sergeyyarkov/attiny2313a_thermostat/(list of files, cad)

Other CAD files:
firmware/dist/default/production/firmware.production.obj
