sergeyyarkov/attiny2313a_thermostat/(list of files, drawings)

Other design files:
proteus/thermostat.pdsprj
