sergeyyarkov/attiny2313a_thermostat/hardware/hardware/hardware.kicad_pcb

## KiCad design hardware/hardware/hardware.kicad_pcb (2023-07-24)

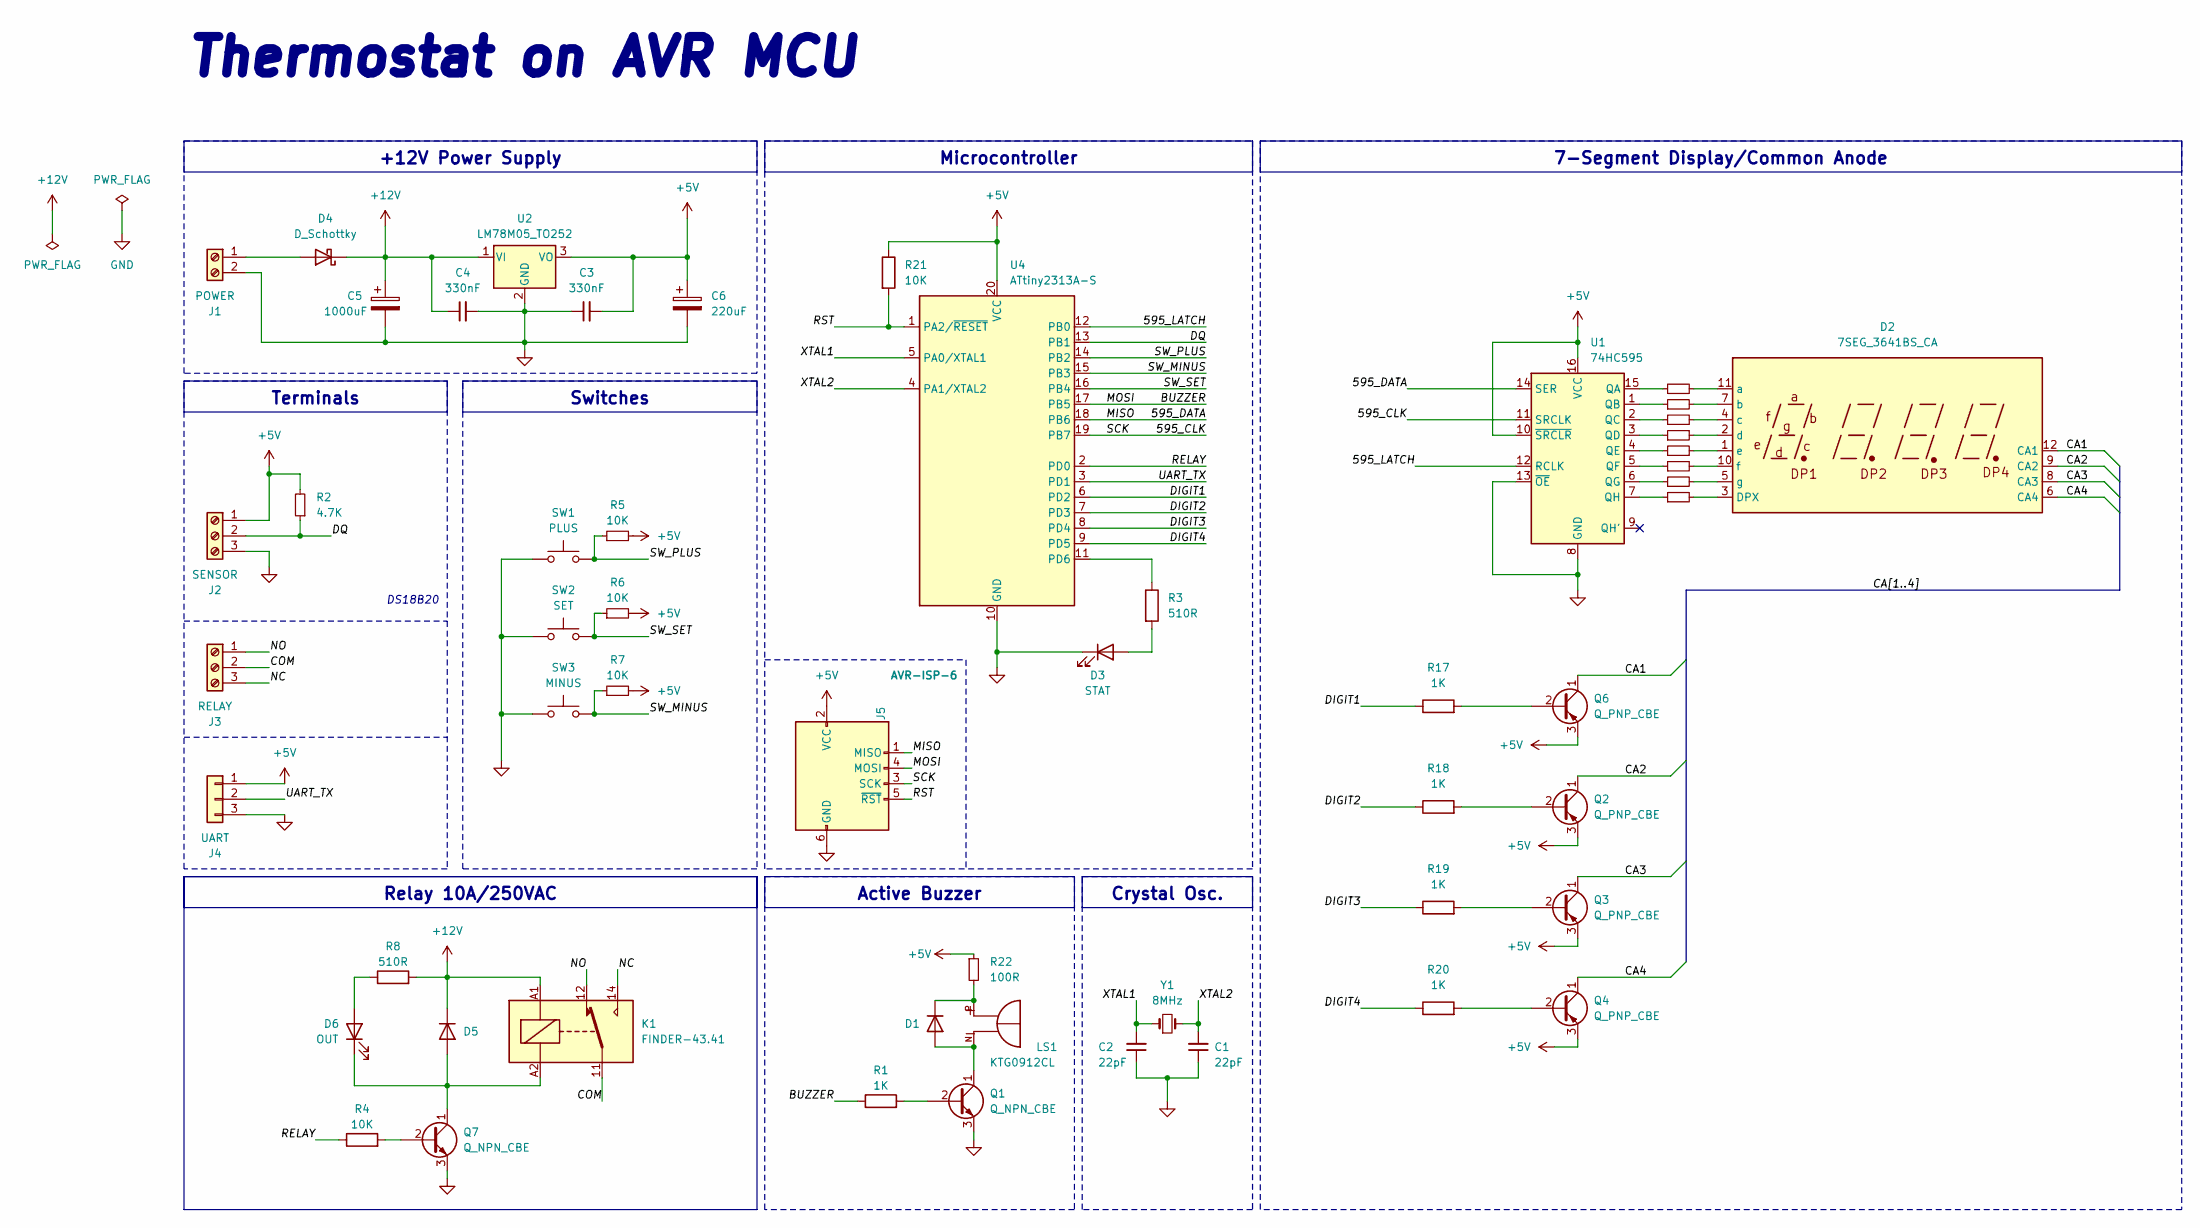
[picture p1: schematic hardware.kicad_sch, Thermostat on ATtiny2313A]

Parts:
C1, C2: 22pF; C_0805_2012Metric
C3, C4: 330nF; C_0805_2012Metric
C5: 1000uF; CP_Elec_10x10.5
C6: 220uF; CP_Elec_6.3x7.7
D1: 1N4448W; D_SOD-123
D2: 7SEG_3641BS_CA; 7SEG_3641BS
D3: STAT; LED_0805_2012Metric
D4: D_Schottky; D_SMA
D5: D; D_SMA
D6: OUT; LED_0805_2012Metric
J1: POWER; TerminalBlock_Phoenix_MPT-0,5-2-2.54_1x02_P2.54mm_Horizontal
J2: SENSOR; TerminalBlock_Phoenix_MPT-0,5-3-2.54_1x03_P2.54mm_Horizontal
J3: RELAY; TerminalBlock_Phoenix_MPT-0,5-3-2.54_1x03_P2.54mm_Horizontal
J4: UART; PinHeader_1x03_P2.54mm_Vertical
J5: AVR-ISP-6; PinHeader_2x03_P2.54mm_Vertical
K1: FINDER-43.41; RELAY_FINDER-43.41
LS1: KTG0912CL; XDCR_KTG0912CL; PARTREV 1.1
Q1, Q7: Q_NPN_CBE; SOT-23
Q2, Q3, Q4, Q6: Q_PNP_CBE; SOT-23
R1, R17, R18, R19, R20: 1K; R_0805_2012Metric
R2: 4.7K; R_0805_2012Metric
R3, R8: 510R; R_0805_2012Metric
R4, R5, R6, R7, R21: 10K; R_0805_2012Metric
R9, R10, R11, R12, R13, R14, R15, R16: 330R; R_0805_2012Metric
R22: 100R; R_0805_2012Metric
SW1: PLUS; SW_Push_1P1T_NO_6x6mm_H9.5mm
SW2: SET; SW_Push_1P1T_NO_6x6mm_H9.5mm
SW3: MINUS; SW_Push_1P1T_NO_6x6mm_H9.5mm
U1: 74HC595; SOIC-16W_5.3x10.2mm_P1.27mm
U2: LM78M05_TO252; TO-252-2
U4: ATtiny2313A-S; SOIC-20W_7.5x12.8mm_P1.27mm
Y1: 8MHz; Crystal_HC49-4H_Vertical

Connections:
+5V: C3.2, C6.1, J2.1, J4.1, J5.2 (VCC), Q2.3 (E), Q3.3 (E), Q4.3 (E), Q6.3 (E), R2.2, R5.2, R6.2, R7.2, R21.1, R22.1, U1.10 (~SRCLR), U1.16 (VCC), U2.3 (VO), U4.20 (VCC)
+12V: C4.1, C5.1, D4.1 (K), D5.1 (K), K1.A1, R8.2, U2.1 (VI)
/595_CLK: J5.3 (SCK), U1.11 (SRCLK), U4.19 (PB7)
/595_DATA: J5.1 (MISO), U1.14 (SER), U4.18 (PB6)
/595_LATCH: U1.12 (RCLK), U4.12 (PB0)
/BUZZER: J5.4 (MOSI), R1.1, U4.17 (PB5)
/CA1: D2.12 (CA1), Q6.1 (C)
/CA2: D2.9 (CA2), Q2.1 (C)
/CA3: D2.8 (CA3), Q3.1 (C)
/CA4: D2.6 (CA4), Q4.1 (C)
/COM: J3.2, K1.11
/DIGIT1: R17.1, U4.6 (PD2)
/DIGIT2: R18.1, U4.7 (PD3)
/DIGIT3: R19.1, U4.8 (PD4)
/DIGIT4: R20.1, U4.9 (PD5)
/DQ: J2.2, R2.1, U4.13 (PB1)
/NC: J3.3, K1.14
/NO: J3.1, K1.12
/RELAY: R4.1, U4.2 (PD0)
/RST: J5.5 (~RST), R21.2, U4.1 (PA2/~RESET)
/SW_MINUS: R7.1, SW3.2, U4.15 (PB3)
/SW_PLUS: R5.1, SW1.2, U4.14 (PB2)
/SW_SET: R6.1, SW2.2, U4.16 (PB4)
/UART_TX: J4.2, U4.3 (PD1)
/XTAL1: C2.2, U4.5 (PA0/XTAL1), Y1.1
/XTAL2: C1.2, U4.4 (PA1/XTAL2), Y1.2
GND: C1.1, C2.1, C3.1, C4.2, C5.2, C6.2, D3.1 (K), J1.2, J2.3, J4.3, J5.6 (GND), Q1.3 (E), Q7.3 (E), SW1.1, SW2.1, SW3.1, U1.8 (GND), U1.13 (~OE), U2.2 (GND), U4.10 (GND)
unnamed: D1.2 (A), LS1.N, Q1.1 (C)
unnamed: D1.1 (K), LS1.P, R22.2
unnamed: D2.3 (DPX), R16.2
unnamed: D2.11 (a), R9.2
unnamed: D2.7 (b), R10.2
unnamed: D2.4 (c), R11.2
unnamed: D2.2 (d), R12.2
unnamed: D2.1 (e), R13.2
unnamed: D2.10 (f), R14.2
unnamed: D2.5 (g), R15.2
unnamed: D3.2 (A), R3.2
unnamed: D4.2 (A), J1.1
unnamed: D5.2 (A), D6.1 (K), K1.A2, Q7.1 (C)
unnamed: D6.2 (A), R8.1
unnamed: Q1.2 (B), R1.2
unnamed: Q2.2 (B), R18.2
unnamed: Q3.2 (B), R19.2
unnamed: Q4.2 (B), R20.2
unnamed: Q6.2 (B), R17.2
unnamed: Q7.2 (B), R4.2
unnamed: R9.1, U1.15 (QA)
unnamed: R10.1, U1.1 (QB)
unnamed: R11.1, U1.2 (QC)
unnamed: R12.1, U1.3 (QD)
unnamed: R13.1, U1.4 (QE)
unnamed: R14.1, U1.5 (QF)
unnamed: R15.1, U1.6 (QG)
unnamed: R16.1, U1.7 (QH)
unnamed: R3.1, U4.11 (PD6)

Notes on the sheet:
Active Buzzer
Terminals
+12V Power Supply
Crystal Osc.
Relay 10A/250VAC
Switches
7-Segment Display/Common Anode
Microcontroller
Thermostat on AVR MCU
DS18B20

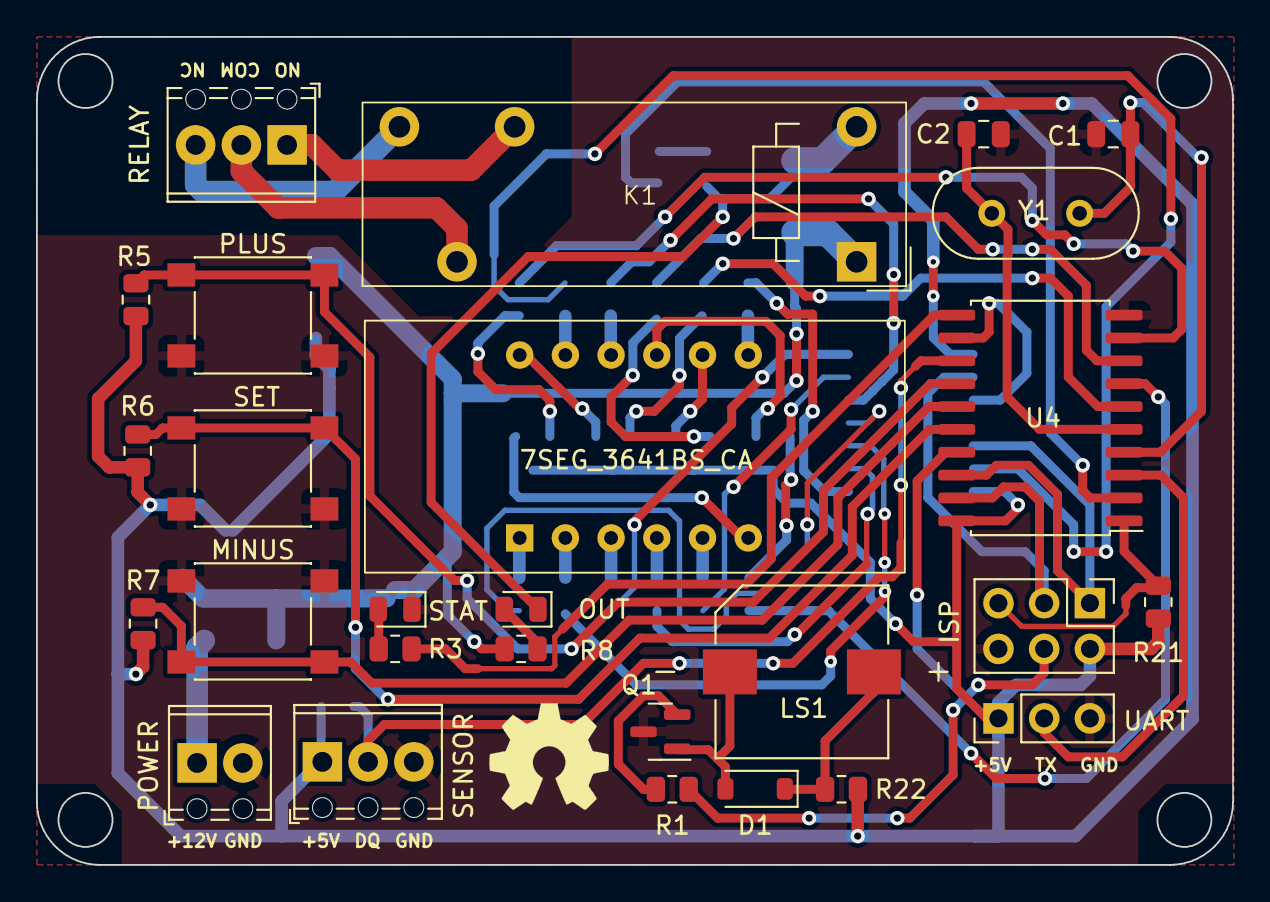
[picture p2: board hardware.kicad_pcb from above]

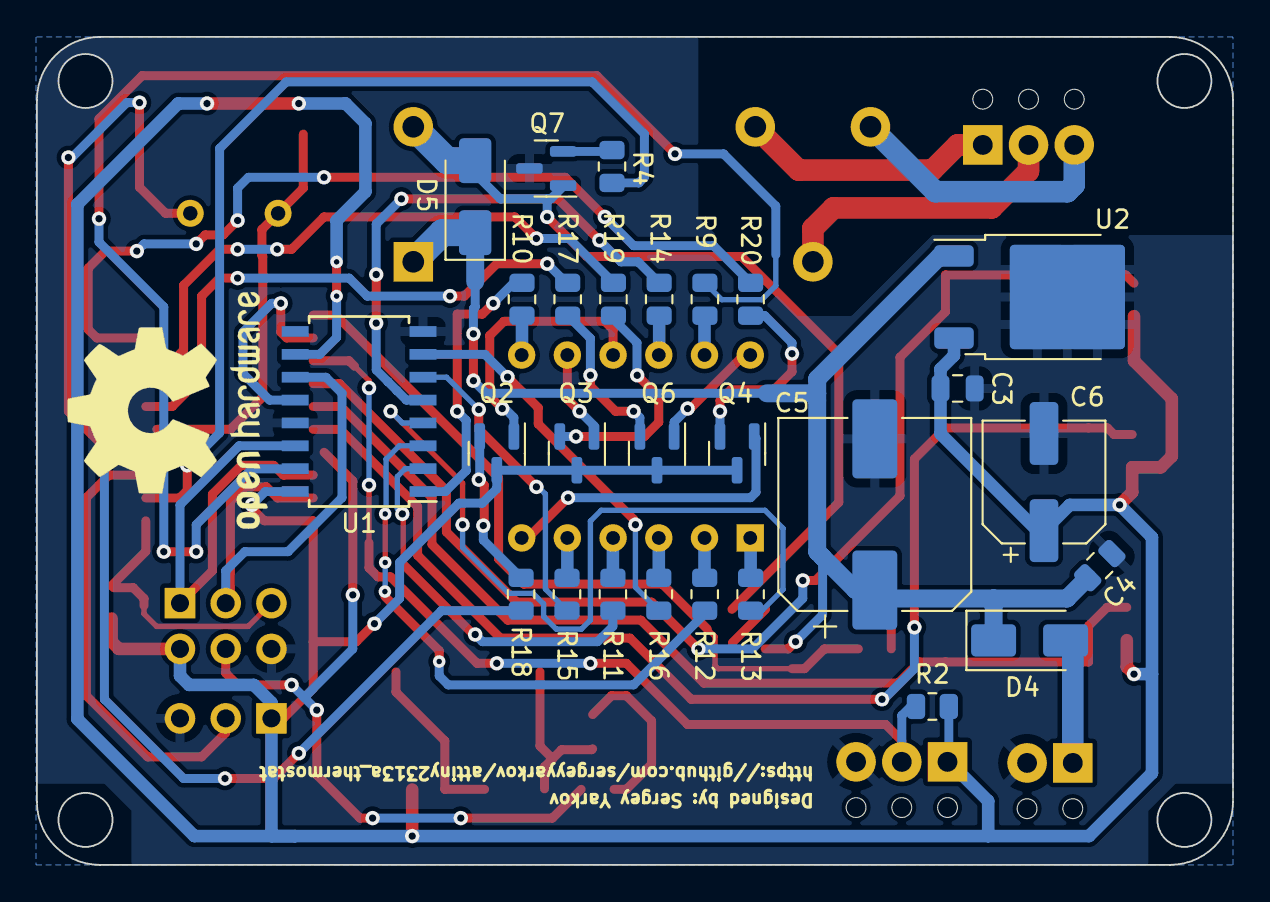
[picture p3: board hardware.kicad_pcb from below]

Board: 2 copper layers, 66.5 x 46.0 mm, 54 parts (27 on the bottom side), 56 nets.
