sergeyyarkov/attiny2313a_thermostat/(commit log)

2023-05-10 1 wire presence detect
2023-06-19 one wire impl
2023-06-19 read temperature
    [attiny2313a_thermostat.X.production.obj]
2023-06-20 support signed ints
    [attiny2313a_thermostat.X.production.obj]
2023-06-20 support signed and unsigned fractional part
    [attiny2313a_thermostat.X.production.obj]
2023-06-22 fix dynamic indication
    [attiny2313a_thermostat.X.production.obj]
2023-06-22 relay pin
    [attiny2313a_thermostat.X.production.obj]
2023-06-24 check sensor family code
    [attiny2313a_thermostat.X.production.obj]
2023-06-25 read family code from ROM
    [attiny2313a_thermostat.X.production.obj]
2023-06-25 temperature comparsion
    [attiny2313a_thermostat.X.production.obj]
2023-06-26 cooling & heating modes compare
    [attiny2313a_thermostat.X.production.obj]
2023-06-26 send data to uart
    [attiny2313a_thermostat.X.production.obj]
2023-06-29 change hyst & temp settings
    [attiny2313a_thermostat.X.production.obj]
2023-06-29 program mode setting
    [attiny2313a_thermostat.X.production.obj]
2023-06-29 changed set temperature step
    [attiny2313a_thermostat.X.production.obj]
2023-06-30 save setting to eeprom
    [attiny2313a_thermostat.X.production.obj]
2023-06-30 min & max limit for temp setting
    [attiny2313a_thermostat.X.production.obj]
2023-07-01 fixed dot
    [attiny2313a_thermostat.X.production.obj]
2023-07-01 folder structure
    [firmware.production.obj]
2023-07-01 terminal view in web-browser
    [firmware.production.obj]
2023-07-01 add proteus project file
    [thermostat.pdsprj]
2023-07-02 create project
    [hardware.kicad_pcb, hardware.kicad_sch]
